SethHibpshman/EWU-ASME-SDC-2027-Transmitter/hardware/fabrication/production_files/BOM-transmitter.csv

Comment | Designator | Footprint | LCSC | Quantity
0.5Ω | R4 | R_0805 | C28319 | 1
100kΩ | R13,R14,R15,R17 | R_0805 | C25611 | 4
100nF | C1,C16,C19,C20,C21,C22,C23,C24,C25 | C_0805 | C49678 | 9
100Ω | R10 | R_0805 | C17408 | 1
10kΩ | R6 | R_0805 | C17414 | 1
10uF | C15,C2,C3 | C_0805 | C15850 | 3
2.2uF | C18 | C_0805 | C377773 | 1
220Ω | R16,R3 | R_0805 | C17557 | 2
22uF | C10,C11,C12,C13,C14 | C_0805 | C45783 | 5
2N7000 | Q1 | TO-92_Inline | C9114 | 1
2Ω | R7 | R_0805 | C44051 | 1
3kΩ | R8,R9 | R_0805 | C25633 | 2
4.7uF | C17 | C_0805 | C1779 | 1
HS13L03W2C01 | OLED1 | OLED-TH_L35.4-W33.5_HS13L03W2C01 | C7465997 | 1
IP3005A | U3 | ESOP-8_L4.9-W3.9-P1.27-LS6.0-BL-EP | C181685 | 1
IP5306-I2C | U2 | ESOP-8_L4.9-W3.9-P1.27-LS6.0-BL-EP2.0 | C488349 | 1
RK09K1130AAU | R11,R12 | RES-TH_RK09K1130AAU | C202373 | 2
SS34 | D4 | D_SMA | C8678 | 1
USBLC6-2SC6 | D3 | SOT-23-6_L2.9-W1.6-P0.95-LS2.8-BL | C7519 | 1
XRNR5040-1.0UH/N | L2 | IND-SMD_L5.0-W5.0 | C5339700 | 1
YF16-FL7.2-B5KA | R1,R2 | JOYTICK-TH_YF16-DFL7.2-B5KO-45-10-B5KO-55--RG-A22 | C37323739 | 2
LED | D1 | LED_D5.0mm |  | 1
~ | ESP32-S3 | Devboard_ESP32-S3_N16R8_DualUSB-C_YELUFT |  | 1
