SethHibpshman/EWU-ASME-SDC-2027-Transmitter/hardware/kicad_project_files/transmitter.kicad_pcb

## KiCad design hardware/kicad_project_files/transmitter.kicad_pcb (2026-11-01)

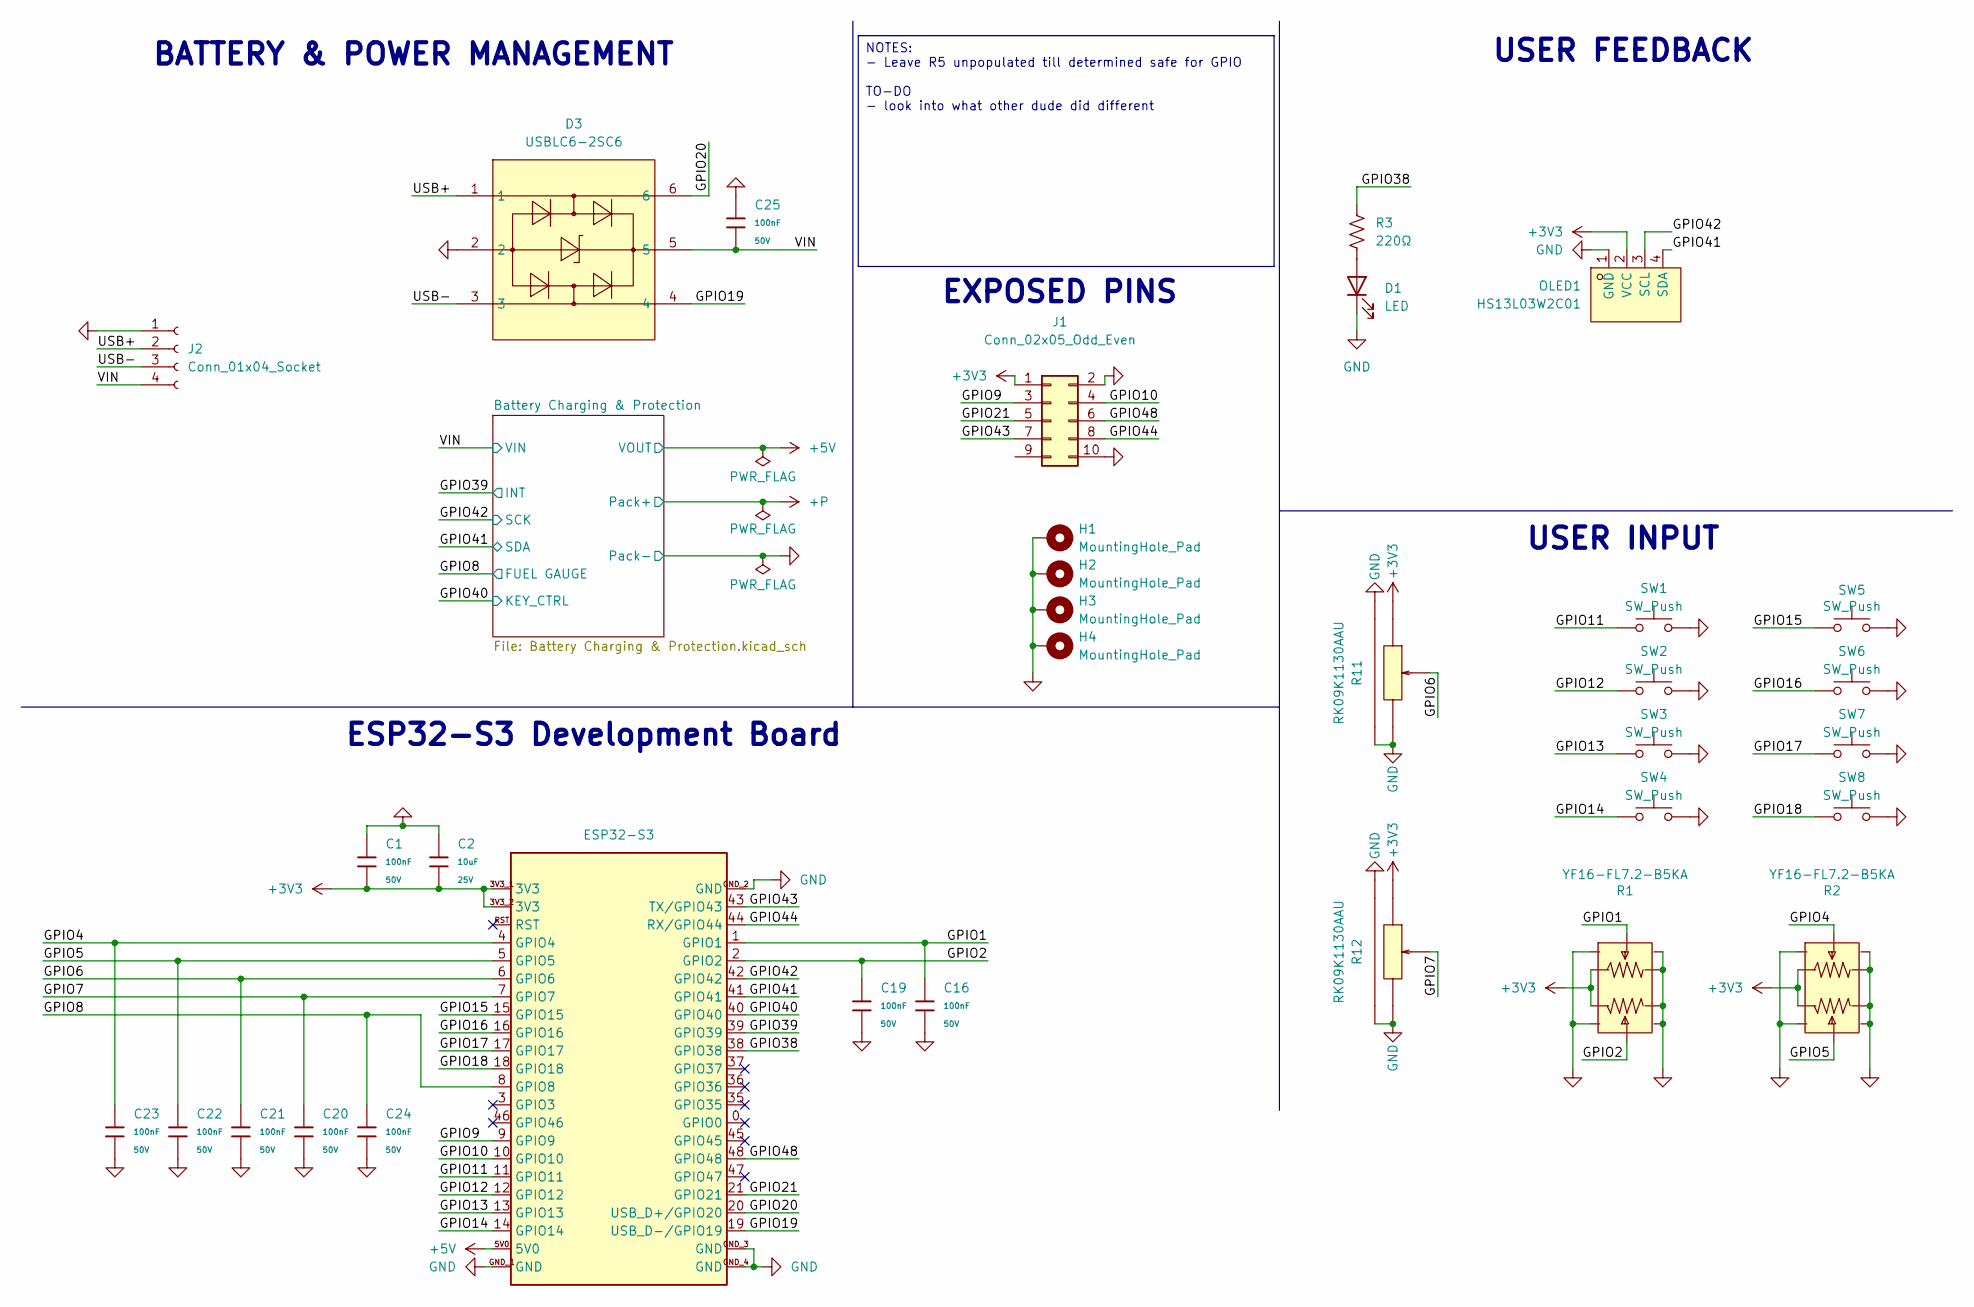
[picture p2: schematic transmitter.kicad_sch, ASME SDC 2027 - Transmitter/Controller]

Parts:
C1, C16, C19, C20, C21, C22, C23, C24, C25: 100nF; C_0805; Voltage Rated 50V; Tolerance ±10%; Part CC0603KRX7R9BB104; LCSC C14663
C2: 10uF; C_0805; Voltage Rated 25V; Tolerance ±20%; Part CL10A106MA8NRNC; LCSC C96446
D1: LED; LED_D5.0mm
D3: USBLC6-2SC6; SOT-23-6_L2.9-W1.6-P0.95-LS2.8-BL; MPN USBLC6-2SC6; LCSC Part C7519
ESP32-S3: Devboard_ESP32-S3_N16R8_DualUSB-C_YELUFT
H1, H2, H3, H4: MountingHole_Pad; MountingHole_3mm_Pad_Via
J1: Conn_02x05_Odd_Even; PinSocket_2x05_P2.54mm_Vertical
J2: Conn_01x04_Socket; PinHeader_1x04_P2.54mm_Vertical
OLED1: HS13L03W2C01; OLED-TH_L35.4-W33.5_HS13L03W2C01; MPN HS13L03W2C01; LCSC Part C7465997
R1, R2: YF16-FL7.2-B5KA; JOYTICK-TH_YF16-DFL7.2-B5KO-45-10-B5KO-55--RG-A22; MPN YF16-FL7.2-B5Ka(45-10)-R-A28; LCSC Part C37323739
R3: 220Ω; R_0805
R11, R12: RK09K1130AAU; RES-TH_RK09K1130AAU; MPN RK09K1130AAU; LCSC Part C202373
SW1, SW2, SW3, SW4, SW5, SW6, SW7, SW8: SW_Push; SW_PUSH-12mm_Wuerth-430476085716

Connections:
+3V3: C1.2, C2.2, ESP32-S3.3V3_1 (3V3), ESP32-S3.3V3_2 (3V3), J1.1, OLED1.2 (VCC), R1.3, R1.6, R2.3, R2.6, R11.3, R12.3; also elsewhere on the board
+5V: ESP32-S3.5V0; also elsewhere on the board
/GPIO1: C16.1, ESP32-S3.1 (GPIO1), R1.2
/GPIO2: C19.1, ESP32-S3.2 (GPIO2), R1.5
/GPIO4: C23.1, ESP32-S3.4 (GPIO4), R2.2
/GPIO5: C22.1, ESP32-S3.5 (GPIO5), R2.5
/GPIO6: C21.1, ESP32-S3.6 (GPIO6), R11.2
/GPIO7: C20.1, ESP32-S3.7 (GPIO7), R12.2
/GPIO8: C24.1, ESP32-S3.8 (GPIO8); also elsewhere on the board
/GPIO9: ESP32-S3.9 (GPIO9), J1.3
/GPIO10: ESP32-S3.10 (GPIO10), J1.4
/GPIO11: ESP32-S3.11 (GPIO11), SW1.1
/GPIO12: ESP32-S3.12 (GPIO12), SW2.1
/GPIO13: ESP32-S3.13 (GPIO13), SW3.1
/GPIO14: ESP32-S3.14 (GPIO14), SW4.1
/GPIO15: ESP32-S3.15 (GPIO15), SW5.1
/GPIO16: ESP32-S3.16 (GPIO16), SW6.1
/GPIO17: ESP32-S3.17 (GPIO17), SW7.1
/GPIO18: ESP32-S3.18 (GPIO18), SW8.1
/GPIO19: D3.4, ESP32-S3.19 (USB_D-/GPIO19)
/GPIO20: D3.6, ESP32-S3.20 (USB_D+/GPIO20)
/GPIO21: ESP32-S3.21 (GPIO21), J1.5
/GPIO38: ESP32-S3.38 (GPIO38), R3.1
/GPIO39: ESP32-S3.39 (GPIO39); also elsewhere on the board
/GPIO40: ESP32-S3.40 (GPIO40); also elsewhere on the board
/GPIO41: ESP32-S3.41 (GPIO41), OLED1.4 (SDA); also elsewhere on the board
/GPIO42: ESP32-S3.42 (GPIO42), OLED1.3 (SCL); also elsewhere on the board
/GPIO43: ESP32-S3.43 (TX/GPIO43), J1.7
/GPIO44: ESP32-S3.44 (RX/GPIO44), J1.8
/GPIO48: ESP32-S3.48 (GPIO48), J1.6
/USB+: D3.1, J2.2
/USB-: D3.3, J2.3
/VIN: C25.2, D3.5, J2.4; also elsewhere on the board
GND: C1.1, C2.1, C16.2, C19.2, C20.2, C21.2, C22.2, C23.2, C24.2, C25.1, D1.1 (K), D3.2, ESP32-S3.GND_1 (GND), ESP32-S3.GND_2 (GND), ESP32-S3.GND_3 (GND), ESP32-S3.GND_4 (GND), H1.1 (1_1), H2.1 (1_1), H3.1 (1_1), H4.1 (1_1), J1.2, J1.10, J2.1, OLED1.1 (GND), R1.1, R1.4, R1.7 (shell), R1.8 (shell), R1.9 (shell), R1.10 (shell), R2.1, R2.4, R2.7 (shell), R2.8 (shell), R2.9 (shell), R2.10 (shell), R11.1, R11.4 (EH), R11.5 (EH), R12.1, R12.4 (EH), R12.5 (EH), SW1.2, SW2.2, SW3.2, SW4.2, SW5.2, SW6.2, SW7.2, SW8.2; also elsewhere on the board
unnamed: D1.2 (A), R3.2

Notes on the sheet:
BATTERY & POWER MANAGEMENT
USER FEEDBACK
ESP32-S3 Development Board
USER INPUT
EXPOSED PINS
NOTES: - Leave R5 unpopulated till determined safe for GPIO TO-DO - look into what other dude did different

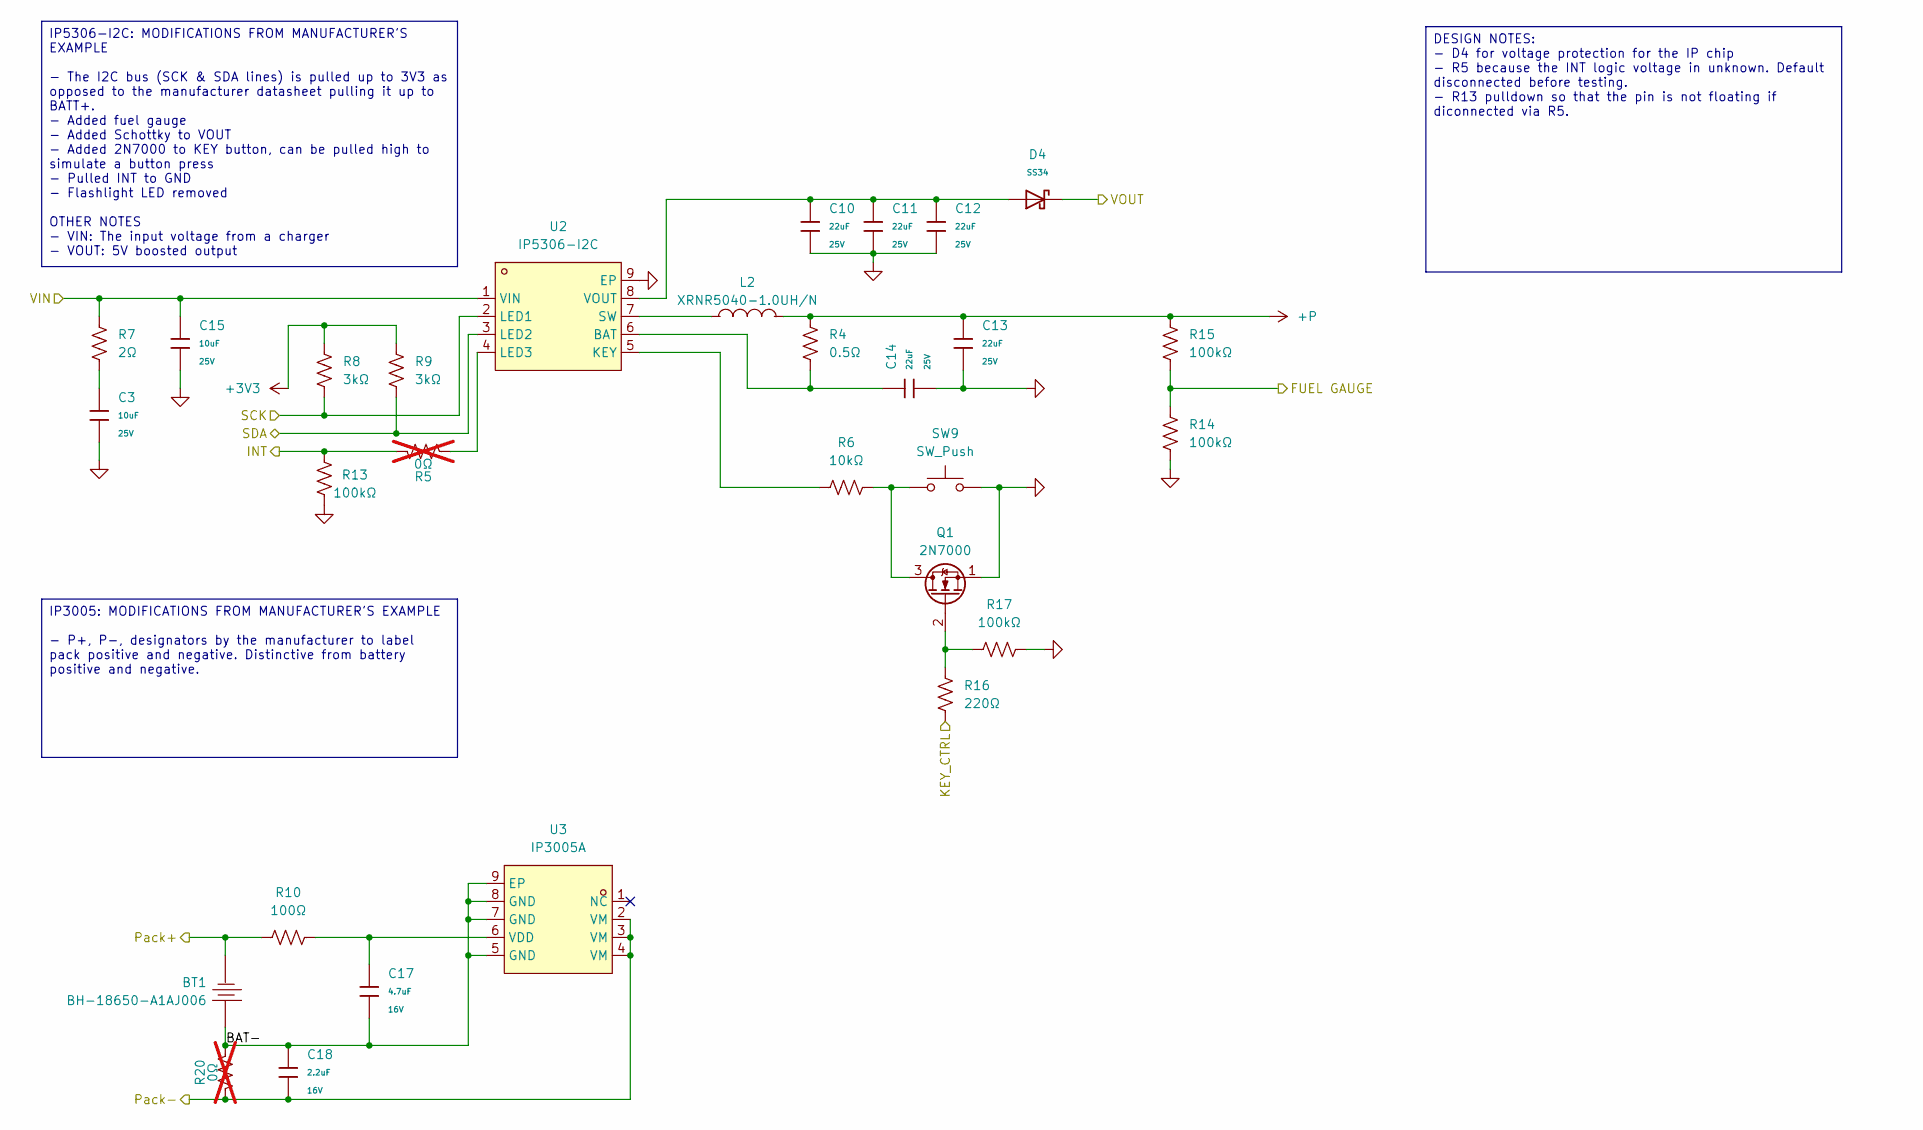
[picture p3: schematic Battery Charging & Protection.kicad_sch]

Parts:
BT1: BH-18650-A1AJ006; PinHeader_1x02_P2.54mm_Vertical; MPN BH-18650-A1AJ006; LCSC Part C5290175
C3, C15: 10uF; C_0805; Voltage Rated 25V; Tolerance ±20%; Part CL10A106MA8NRNC; LCSC C96446
C10, C11, C12, C13, C14: 22uF; C_0805; Voltage Rated 25V; Tolerance ±20%; Part CL21A226MAQNNNE; LCSC C45783
C17: 4.7uF; C_0805; Voltage Rated 16V; Tolerance ±10%; Part CL10A475KO8NNNC; LCSC C19666
C18: 2.2uF; C_0805; Voltage Rated 16V; Tolerance ±10%; Part CL10A225KO8NNNC; LCSC C23630
D4: SS34; D_SMA; Forward Voltage (Vf@If) 550mV@3A; Reverse Voltage (Vr) 40V; Part SS34; LCSC C8678
L2: XRNR5040-1.0UH/N; IND-SMD_L5.0-W5.0; MPN XRNR5040-1.0uH/N; LCSC Part C5339700
Q1: 2N7000; TO-92_Inline
R4: 0.5Ω; R_0805
R5: 0Ω; R_0805; not fitted
R6: 10kΩ; R_0805
R7: 2Ω; R_0805
R8, R9: 3kΩ; R_0805
R10: 100Ω; R_0805
R13, R14, R15, R17: 100kΩ; R_0805
R16: 220Ω; R_0805
R20: 0Ω; R_1206; not fitted
SW9: SW_Push; SW_PUSH-12mm_Wuerth-430476085716
U2: IP5306-I2C; ESOP-8_L4.9-W3.9-P1.27-LS6.0-BL-EP2.0; MPN IP5306-I2C; LCSC Part C488349
U3: IP3005A; ESOP-8_L4.9-W3.9-P1.27-LS6.0-BL-EP; MPN IP3005A; LCSC Part C181685

Connections:
+3V3: R8.1, R9.1; also elsewhere on the board
+5V: D4.1; also elsewhere on the board
+P: BT1.1, C13.1, L2.2, R4.1, R10.1, R15.1; also elsewhere on the board
/Battery Charging & Protection/BAT-: BT1.2, C17.2, C18.1, R20.1, U3.5 (GND), U3.7 (GND), U3.8 (GND), U3.9 (EP); also elsewhere on the board
/GPIO8: R14.1, R15.2; also elsewhere on the board
/GPIO39: R5.1, R13.1; also elsewhere on the board
/GPIO40: R16.1; also elsewhere on the board
/GPIO41: R9.2, U2.3 (LED2); also elsewhere on the board
/GPIO42: R8.2, U2.2 (LED1); also elsewhere on the board
/VIN: C15.1, R7.1, U2.1 (VIN); also elsewhere on the board
GND: C3.2, C10.2, C11.2, C12.2, C13.2, C14.2, C15.2, C18.2, Q1.1 (S), R13.2, R14.2, R17.1, R20.2, SW9.2, U2.9 (EP), U3.2 (VM), U3.3 (VM), U3.4 (VM); also elsewhere on the board
unnamed: C3.1, R7.2
unnamed: Q1.3 (D), R6.2, SW9.1
unnamed: Q1.2 (G), R16.2, R17.2
unnamed: C14.1, R4.2, U2.6 (BAT)
unnamed: R6.1, U2.5 (KEY)
unnamed 42: R5.2, U2.4 (LED3); also elsewhere on the board
unnamed: L2.1, U2.7 (SW)
unnamed: C10.1, C11.1, C12.1, D4.2, U2.8 (VOUT)
unnamed: C17.1, R10.2, U3.6 (VDD)

Notes on the sheet:
DESIGN NOTES: - D4 for voltage protection for the IP chip - R5 because the INT logic voltage in unknown. Default disconnected before testing. - R13 pulldown so that the pin is not floating if diconnected via R5.
IP5306-I2C: MODIFICATIONS FROM MANUFACTURER'S EXAMPLE - The I2C bus (SCK & SDA lines) is pulled up to 3V3 as opposed to the manufacturer datasheet pulling it up to BATT+. - Added fuel gauge - Added Schottky to VOUT - Added 2N7000 to KEY button, can be pulled high to simulate a button press - Pulled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
IP3005: MODIFICATIONS FROM MANUFACTURER'S EXAMPLE - P+, P-, designators by the manufacturer to label pack positive and negative. Distinctive from battery positive and negative.

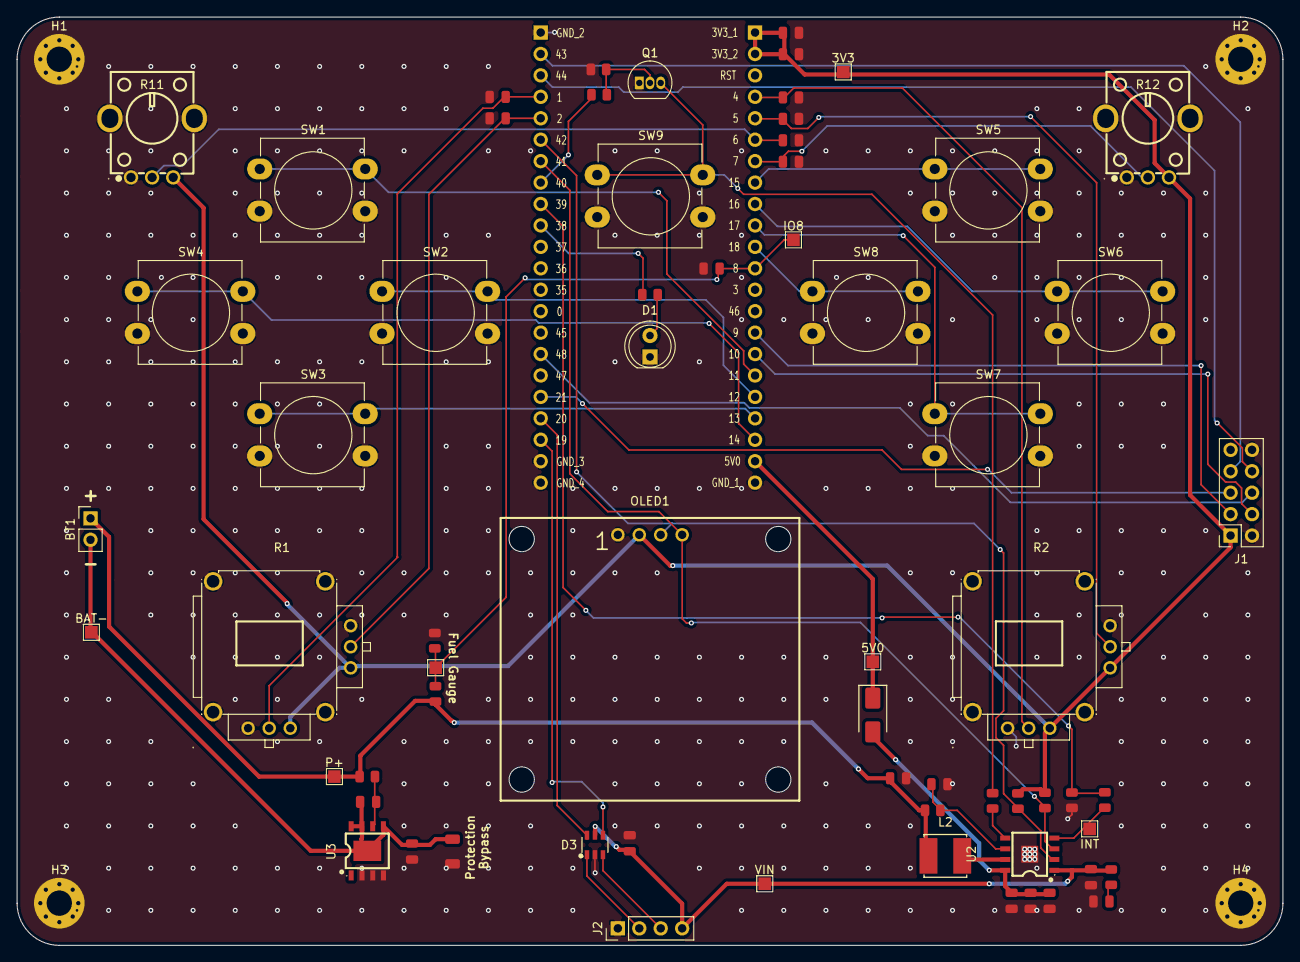
[picture p4: board transmitter.kicad_pcb from above]

Board: 2 copper layers, 150.0 x 110.0 mm, 70 parts (1 on the bottom side), 46 nets.

Other parts of the board:
3V3, 5V0: TestPoint_Pad_1.5x1.5mm
BAT-: TestPoint_Pad_1.5x1.5mm
FUELGAUGE_TEST: TestPoint_Pad_1.5x1.5mm
INT: TestPoint_Pad_1.5x1.5mm
IO8: TestPoint_Pad_1.5x1.5mm
P+: TestPoint_Pad_1.5x1.5mm
VIN: TestPoint_Pad_1.5x1.5mm

Their connections:
+3V3: 3V3.1; also elsewhere on the board
+5V: 5V0.1; also elsewhere on the board
+P: P+.1; also elsewhere on the board
/Battery Charging & Protection/BAT-: BAT-.1; also elsewhere on the board
/GPIO8: FUELGAUGE_TEST.1, IO8.1; also elsewhere on the board
/VIN: VIN.1; also elsewhere on the board
unnamed 42: INT.1; also elsewhere on the board
