SethHibpshman/EWU-ASME-SDC-2027-Transmitter/(commit log)

2026-10-31 Initial commit: KiCad project, README, and draft fabrication files
    [BOM-transmitter.csv, Battery Charging & Protection.kicad_sch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]
2026-11-01 Switch passives to 0805 for hand assembly, remove USB-C, add exposed pads
    Moves resistors and capacitors from 0603 to 0805 so the board can be
    hand-soldered, removes the USB-C connector, and adds exposed pads.
    This lowers cost when assembling in-house. Regenerates the JLCPCB
    Gerbers, BOM, and CPL, and updates the README.
    [BOM-transmitter.csv, Battery Charging & Protection.kicad_sch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]
